albhasan/hci/docs/pictures/IMG_0166.JPG

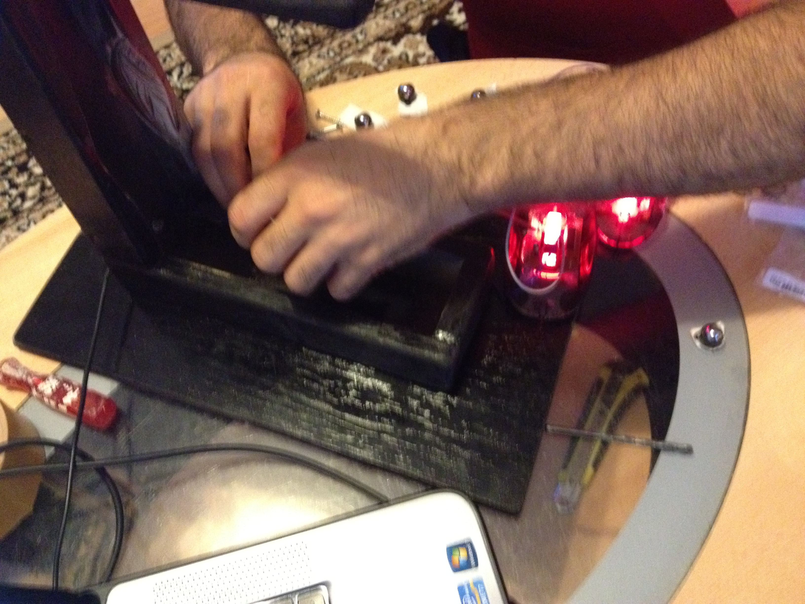
docs/pictures/IMG_0166.JPG
