albhasan/hci/docs/pictures/IMG_0165.JPG

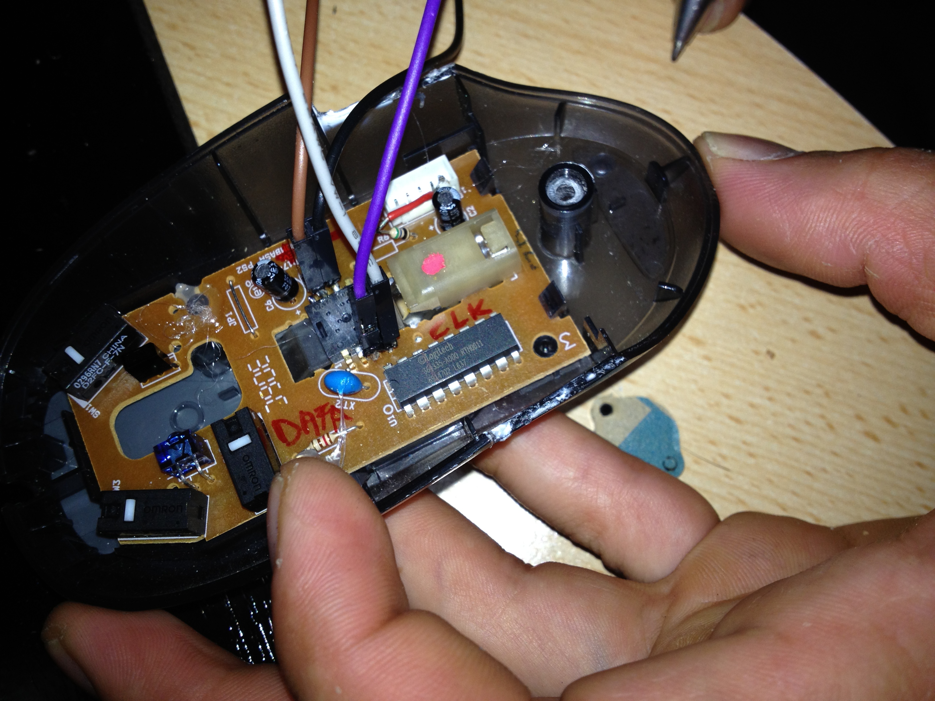
docs/pictures/IMG_0165.JPG
