albhasan/hci/docs/images.pptx

## MATERIALS

- 1 Arduino board
- 1 ball (10 cm diameter)
- 2 mice (ADNS-2610 optical sensor)
- Wood case
- 5 caster balls

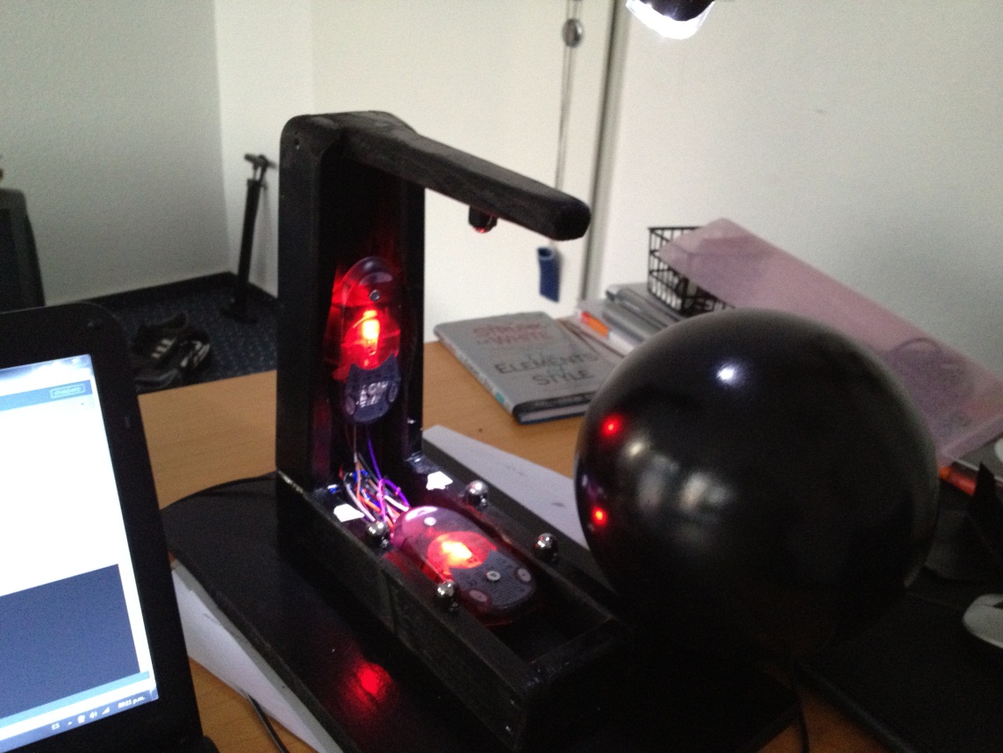
[picture p3: figure]

## SCHEMA

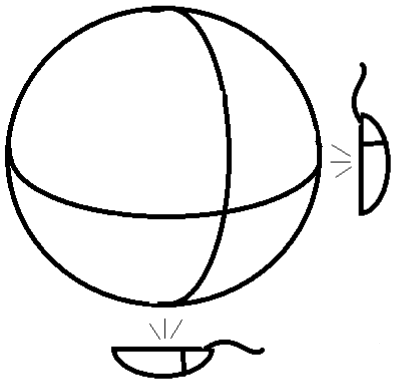
[picture p4: figure]
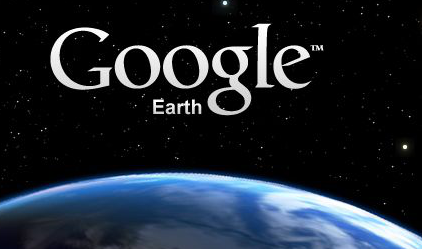
[picture p5: figure]
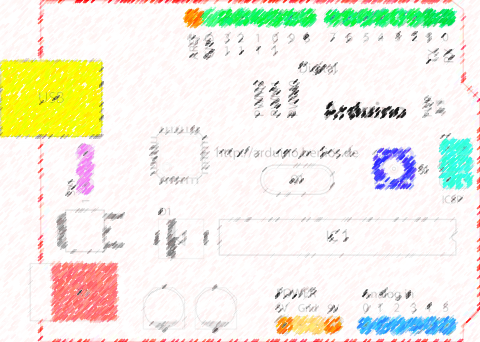
[picture p6: figure]
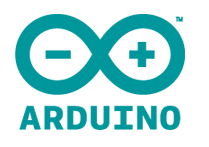
[picture p7: figure]

Client

Serial communication

Server
