albhasan/hci/docs/report/final-eps-converted-to.pdf

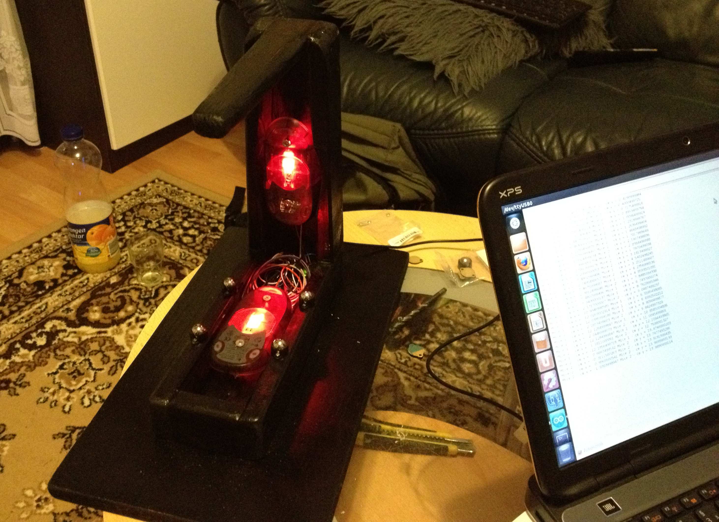
[picture p14: page 1]
