albhasan/hci/docs/pictures/IMG_0153.JPG

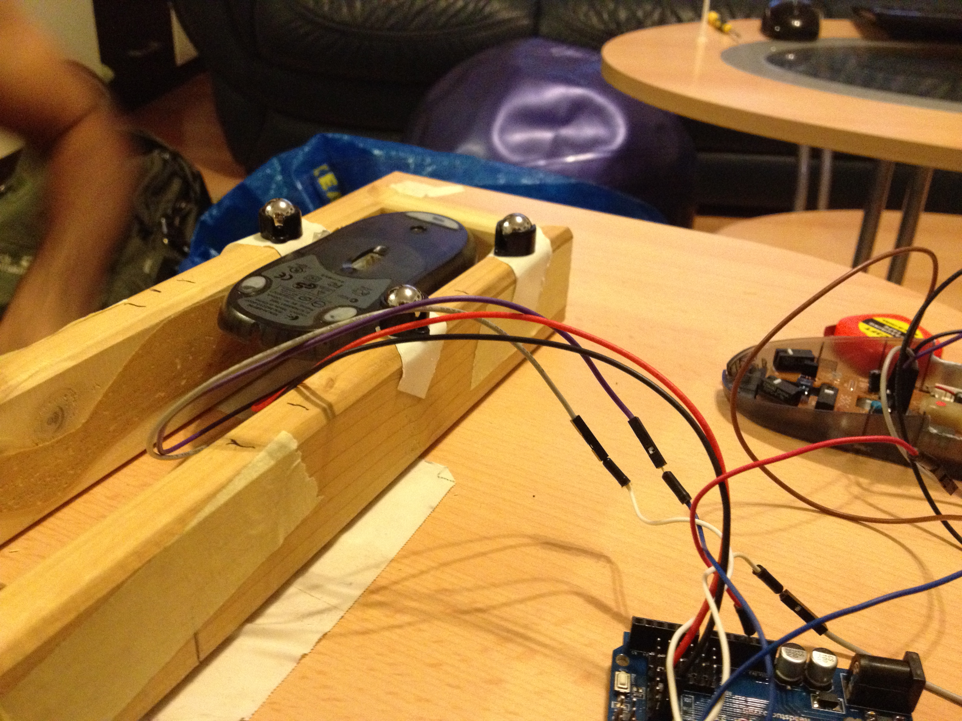
docs/pictures/IMG_0153.JPG
