albhasan/hci/docs/pictures/IMG_0154.JPG

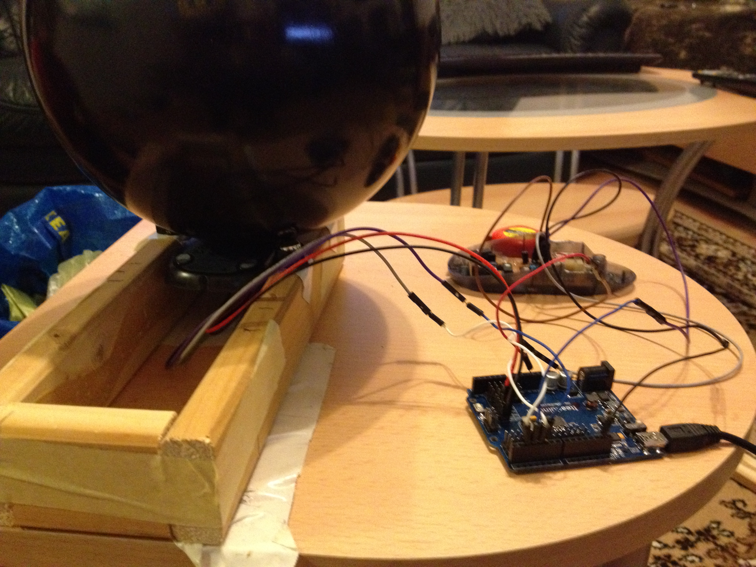
docs/pictures/IMG_0154.JPG
