albhasan/hci/docs/pictures/IMG_0155.JPG

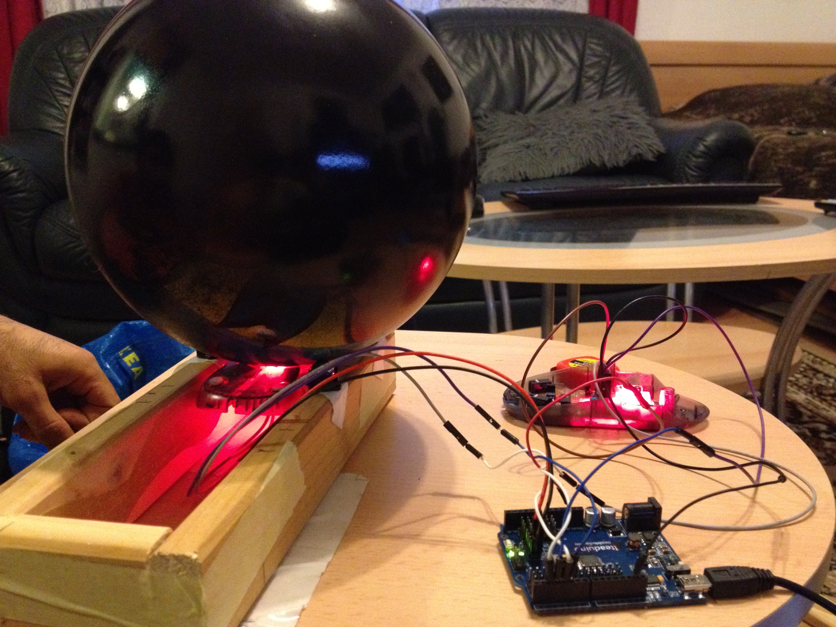
docs/pictures/IMG_0155.JPG
