albhasan/hci/docs/pictures/IMG_0156.JPG

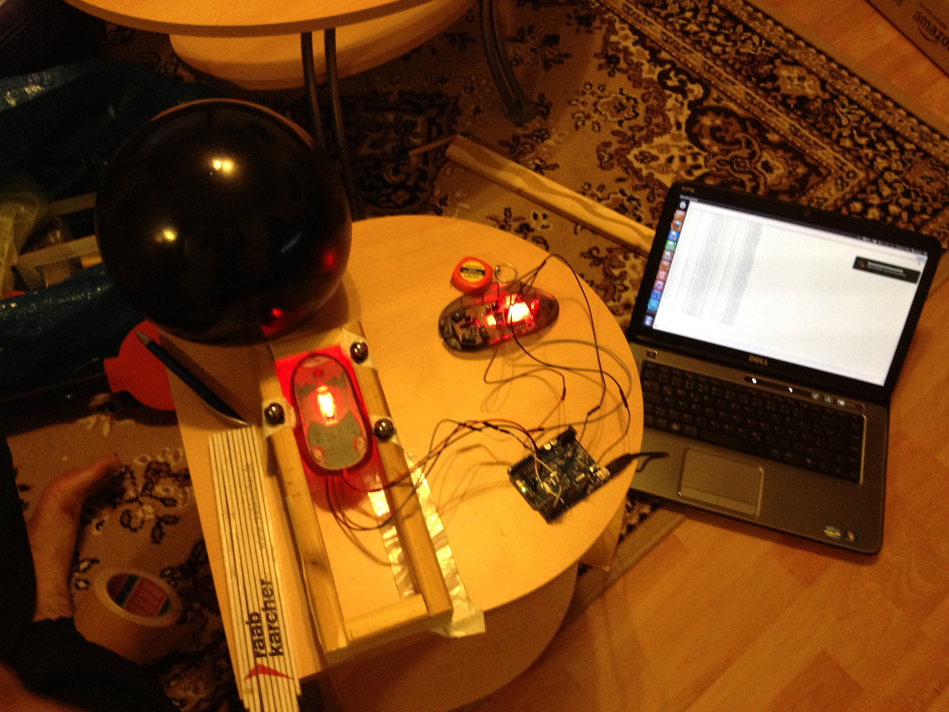
docs/pictures/IMG_0156.JPG
