albhasan/hci/docs/pictures/IMG_0157.JPG

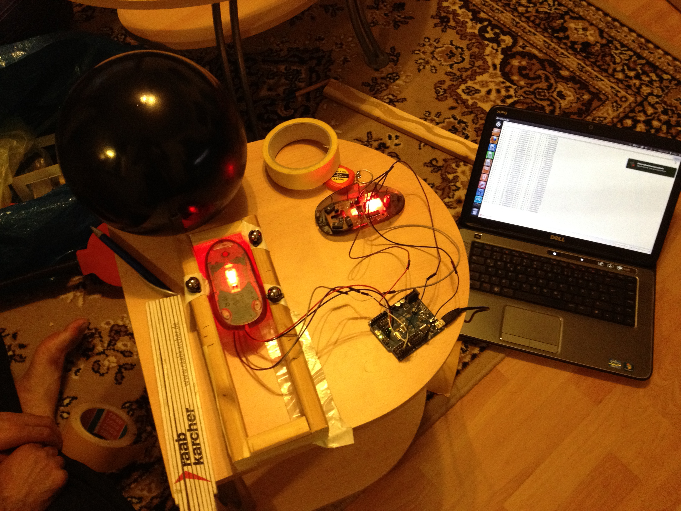
docs/pictures/IMG_0157.JPG
