albhasan/hci/docs/pictures/IMG_0158.JPG

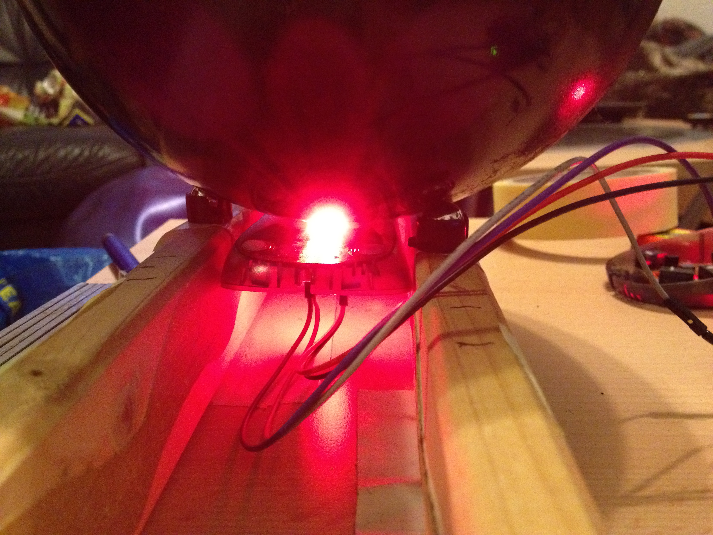
docs/pictures/IMG_0158.JPG
