albhasan/hci/docs/pictures/IMG_0159.JPG

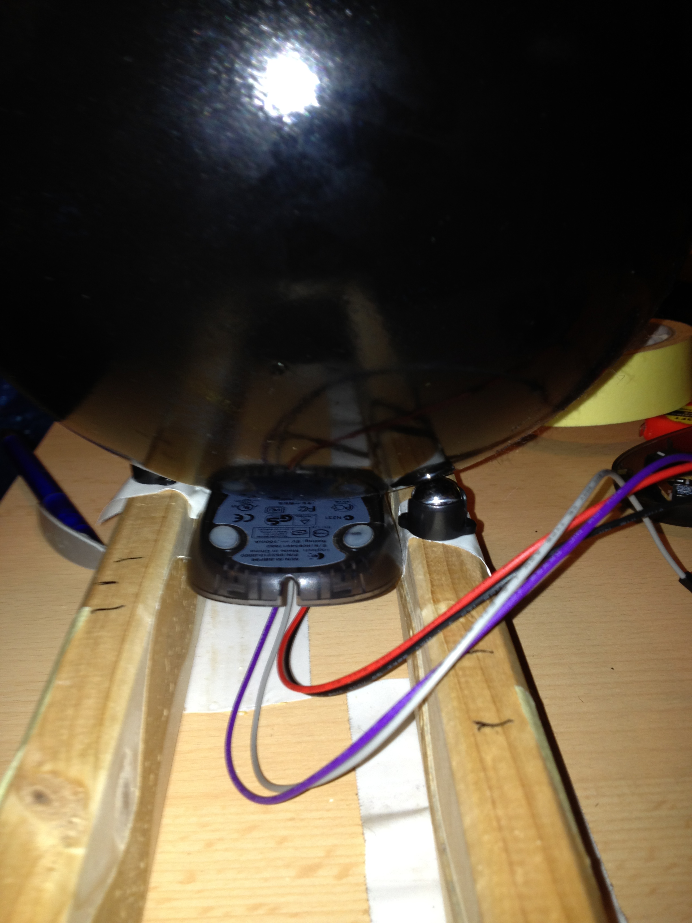
docs/pictures/IMG_0159.JPG
