albhasan/hci/docs/pictures/IMG_0160.JPG

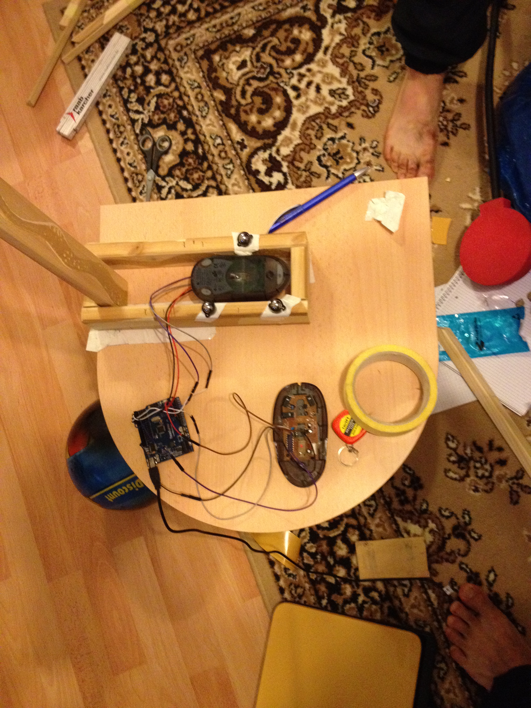
docs/pictures/IMG_0160.JPG
