albhasan/hci/docs/pictures/IMG_0161.JPG

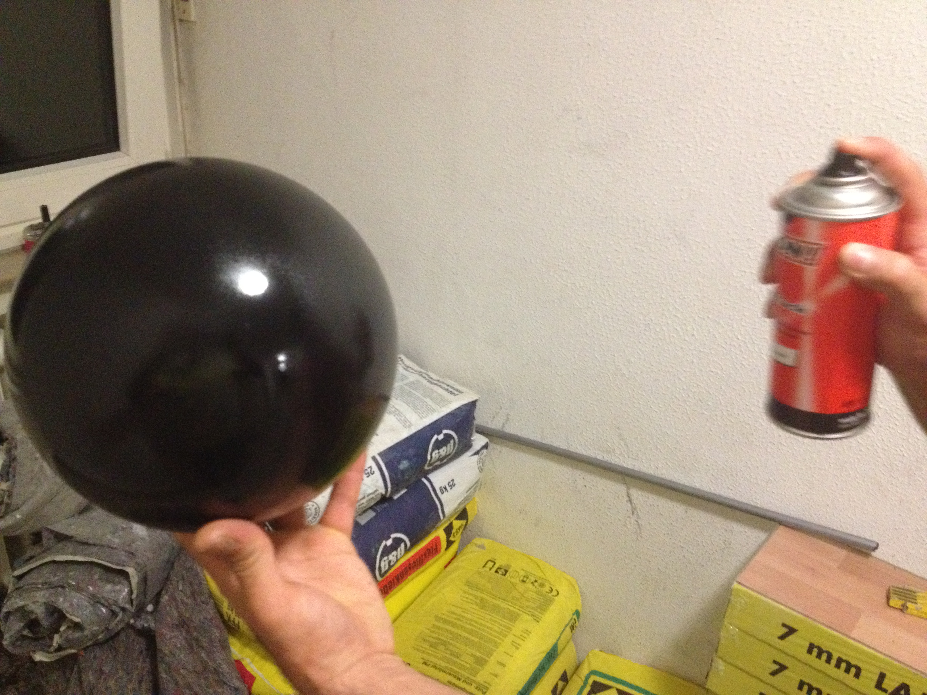
docs/pictures/IMG_0161.JPG
