albhasan/hci/docs/pictures/IMG_0163.JPG

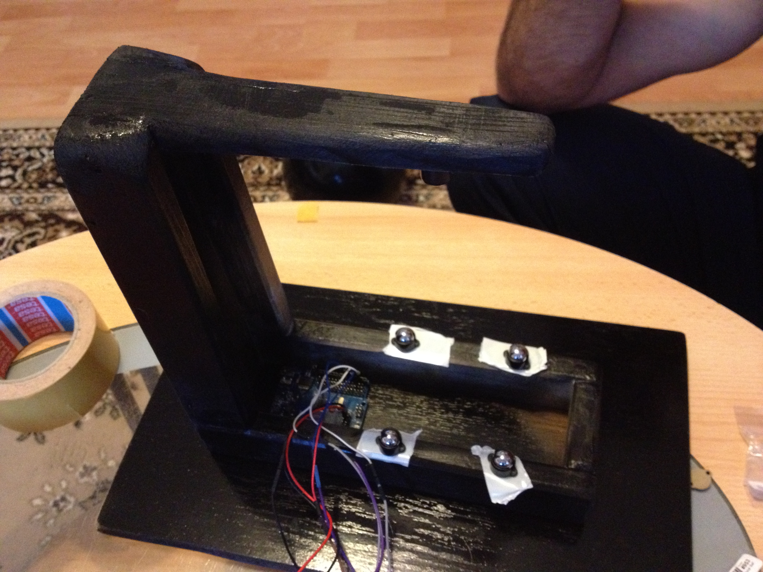
docs/pictures/IMG_0163.JPG
