albhasan/hci/docs/pictures/IMG_0164.JPG

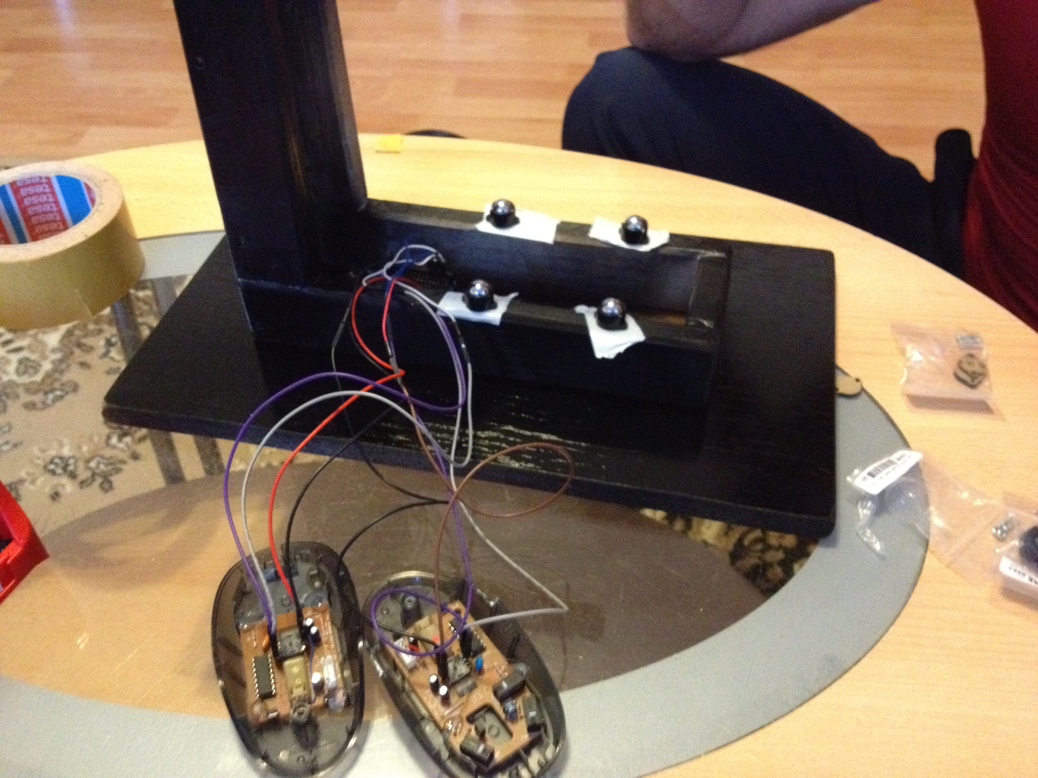
docs/pictures/IMG_0164.JPG
