albhasan/hci/docs/pictures/IMG_0168.JPG

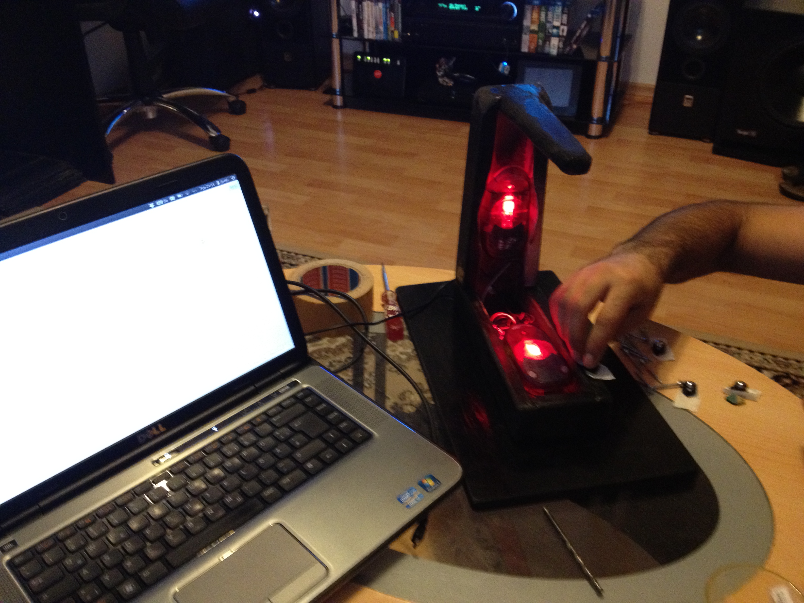
docs/pictures/IMG_0168.JPG
