albhasan/hci/docs/pictures/IMG_0170.JPG

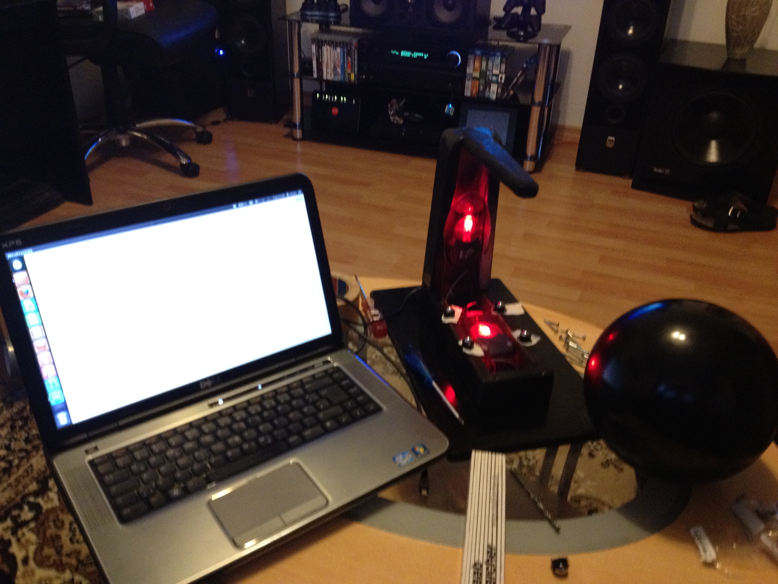
docs/pictures/IMG_0170.JPG
