albhasan/hci/docs/pictures/IMG_0171.JPG

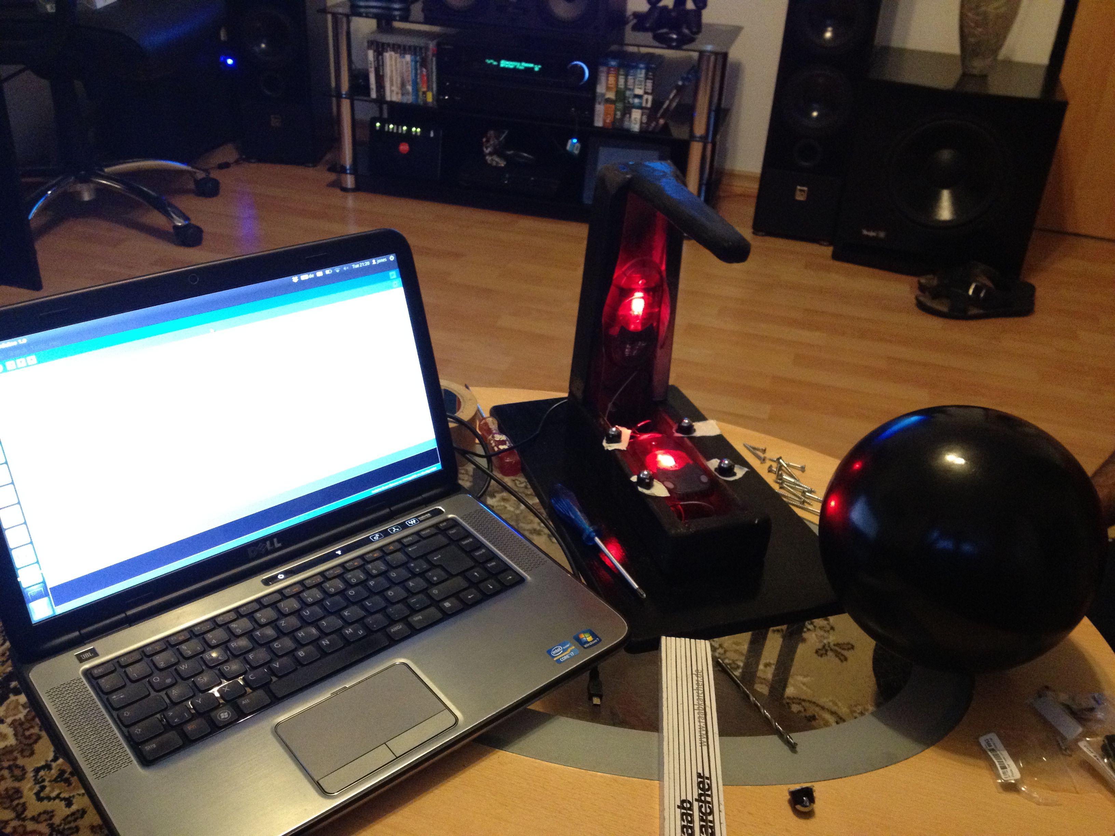
docs/pictures/IMG_0171.JPG
