albhasan/hci/docs/pictures/IMG_0172.JPG

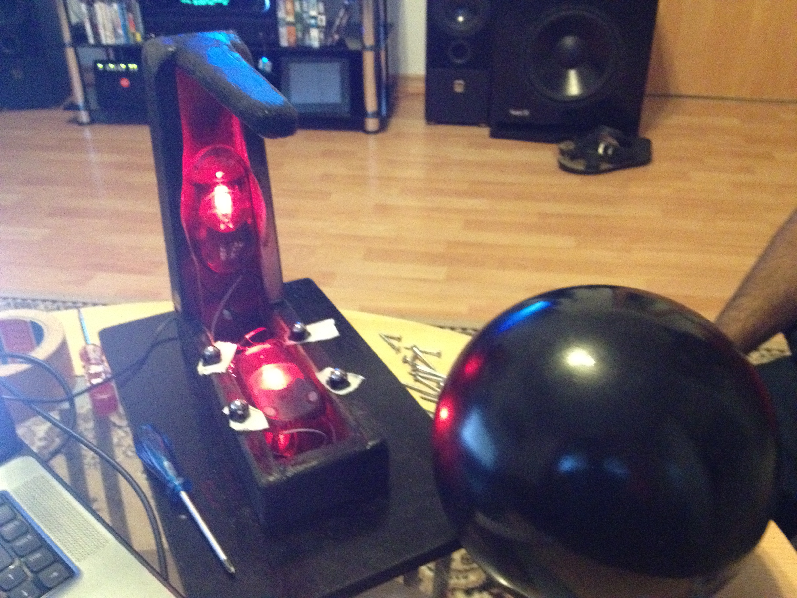
docs/pictures/IMG_0172.JPG
