albhasan/hci/docs/pictures/IMG_0173.JPG

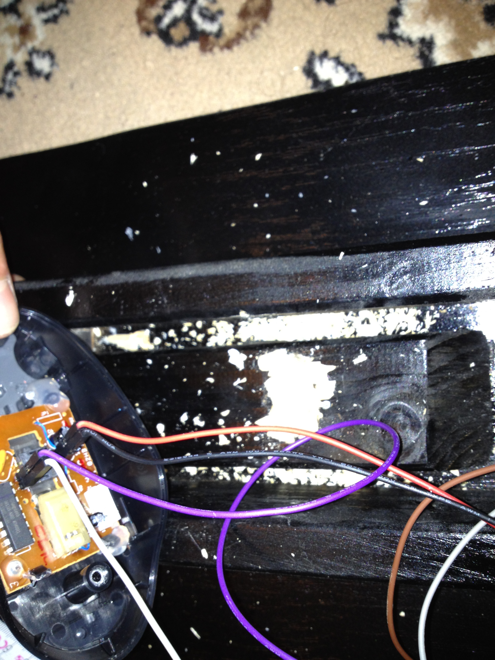
docs/pictures/IMG_0173.JPG
