albhasan/hci/docs/pictures/IMG_0174.JPG

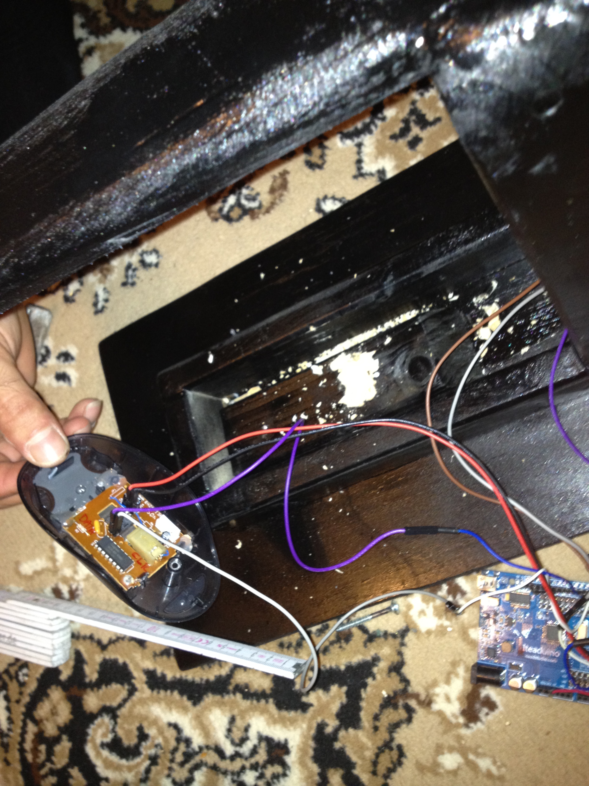
docs/pictures/IMG_0174.JPG
