albhasan/hci/docs/pictures/IMG_0175.JPG

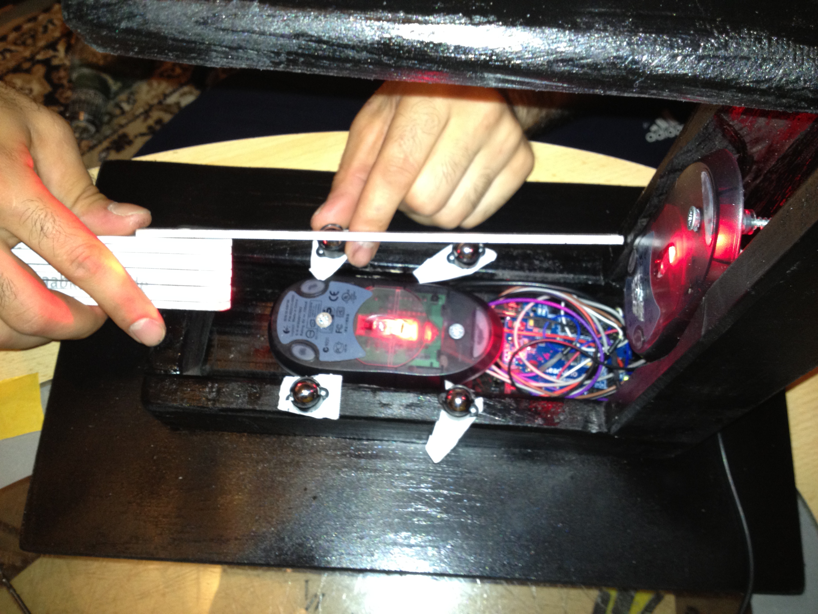
docs/pictures/IMG_0175.JPG
