albhasan/hci/docs/pictures/IMG_0176.JPG

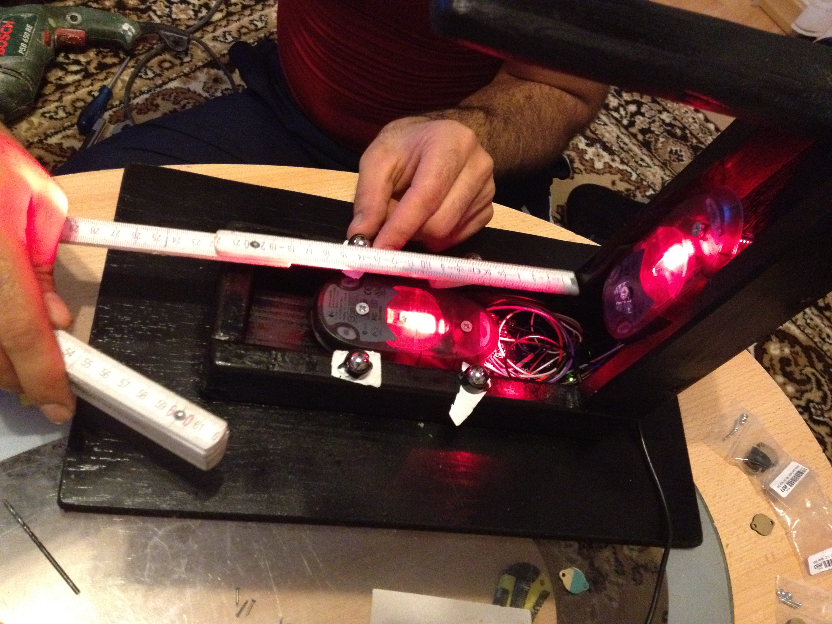
docs/pictures/IMG_0176.JPG
