albhasan/hci/docs/pictures/IMG_0177.JPG

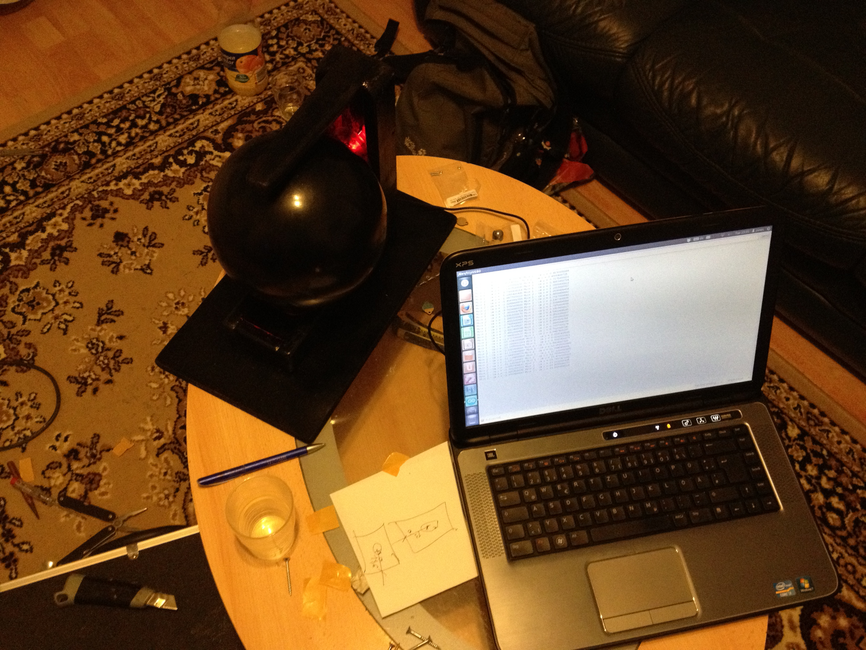
docs/pictures/IMG_0177.JPG
