albhasan/hci/docs/pictures/IMG_0178.JPG

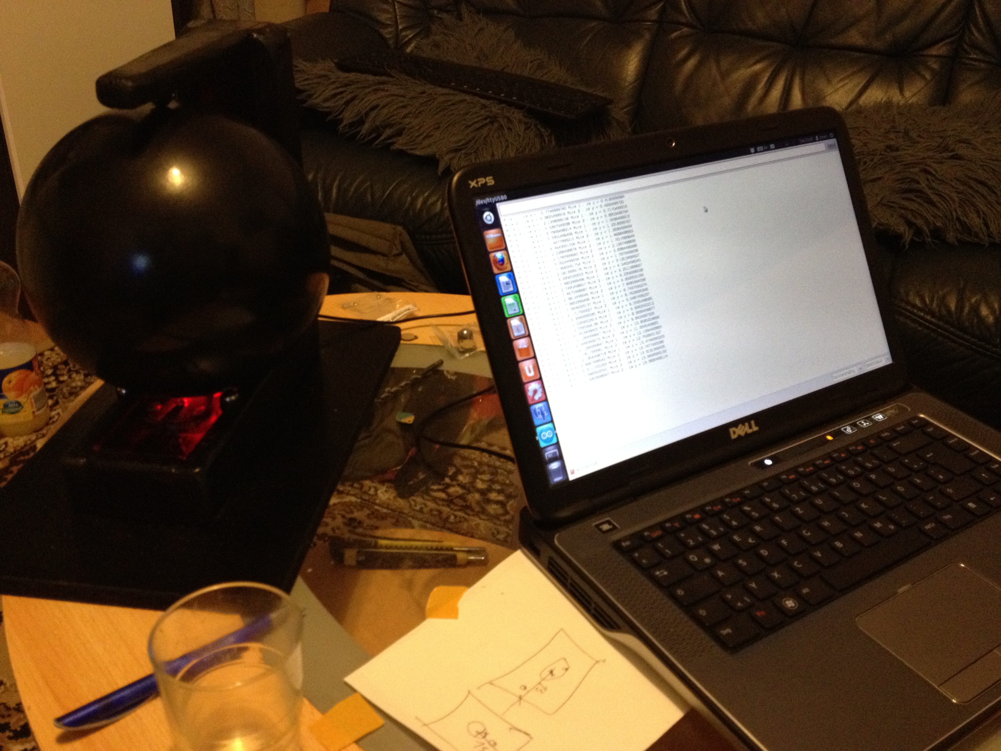
docs/pictures/IMG_0178.JPG
