albhasan/hci/docs/pictures/IMG_0179.JPG

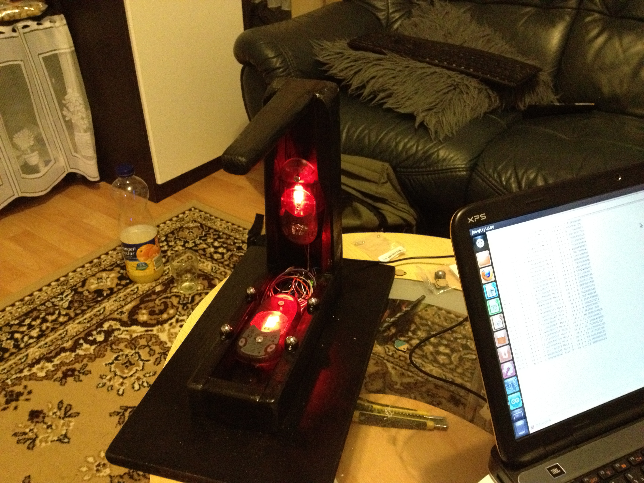
docs/pictures/IMG_0179.JPG
