albhasan/hci/docs/pictures/IMG_0186.JPG

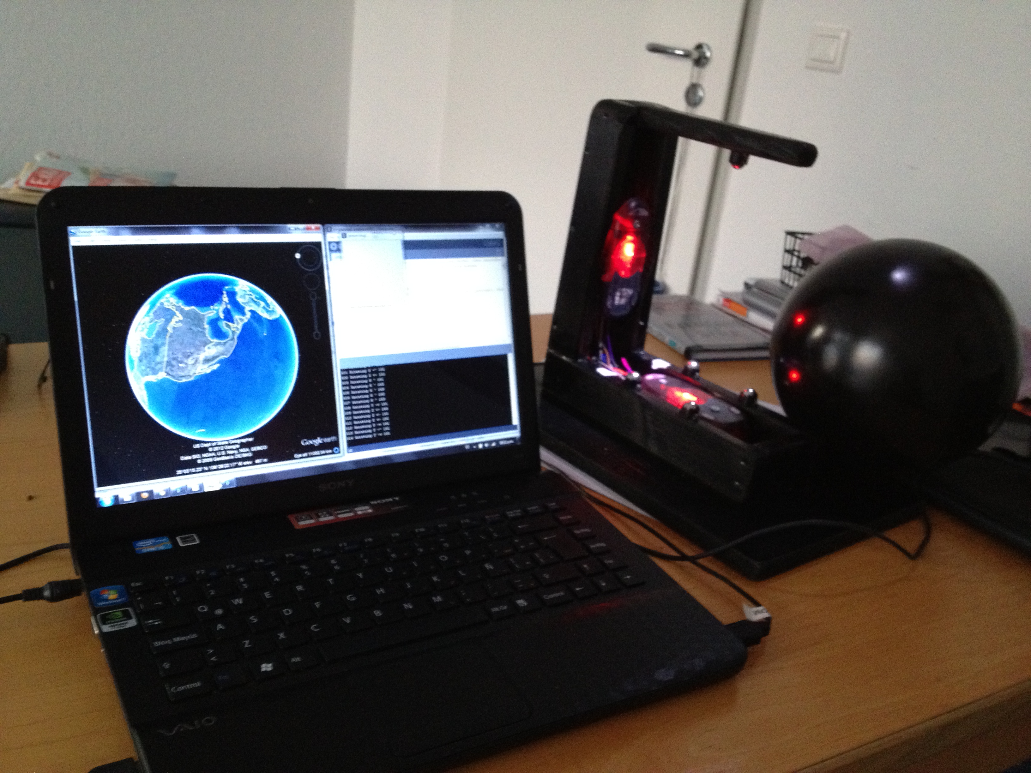
docs/pictures/IMG_0186.JPG
