albhasan/hci/docs/schema.png

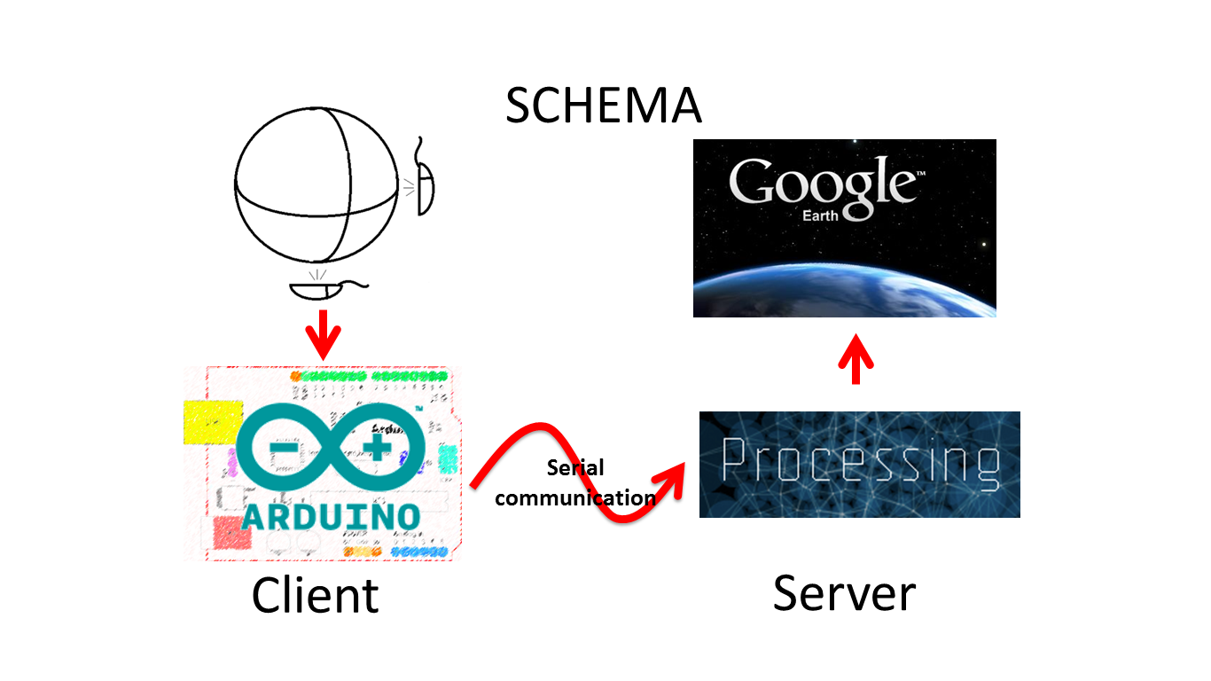
docs/schema.png
