albhasan/hci/docs/materials.png

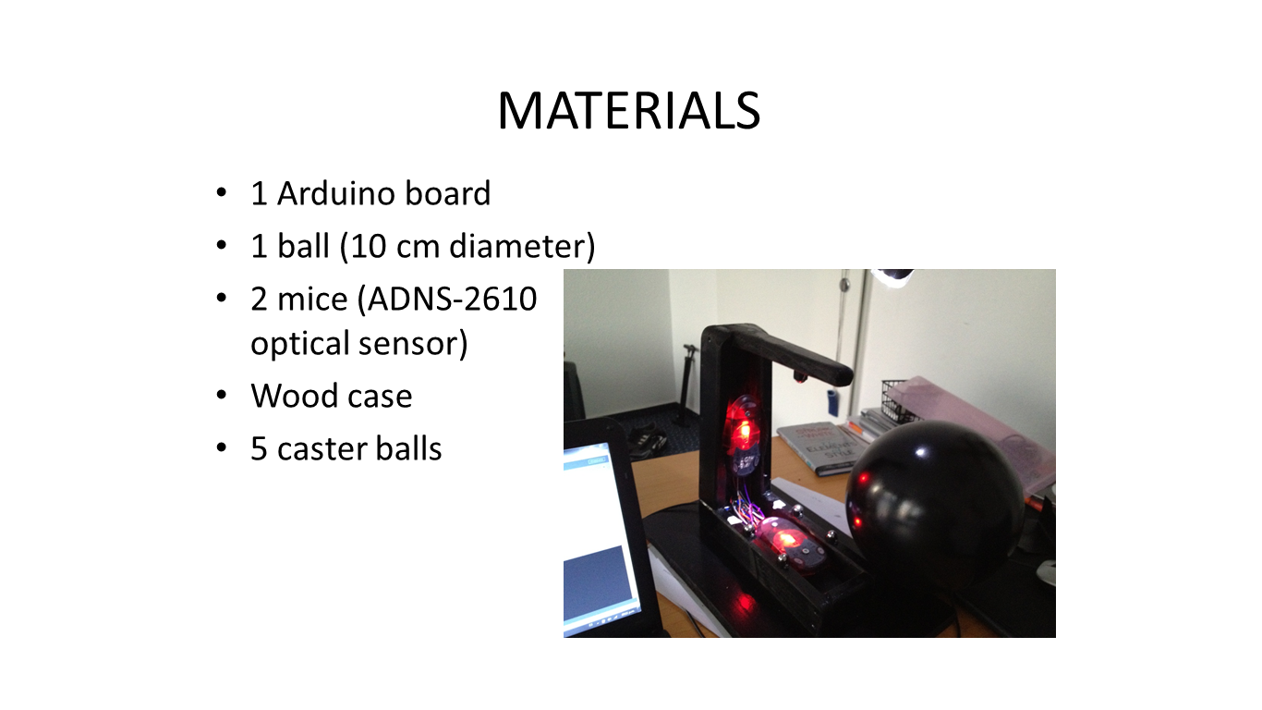
docs/materials.png
