albhasan/hci/arduino_random_mouse_cursors_pontentiometer/arduino_random_mouse_cursors_pontentiometer.ino

// SerialMouse sketch
#define potXPin 4
#define potYPin 5

void setup()
{
Serial.begin(9600);
}
   void loop()
{
    int x = analogRead(potXPin);
    int y = analogRead(potYPin);
    Serial.print(x,DEC);
    Serial.print(",");
    Serial.print(y,DEC);
    Serial.println(); // send a cr/lf
    delay(50); // send position 20 times a second
}
